maxd-out83/ESP32-S3-Small-Camera-PCB-v2.4/ESP32-S3 Small Camera.kicad_pcb

## KiCad design ESP32-S3 Small Camera.kicad_pcb (2026-07-18)

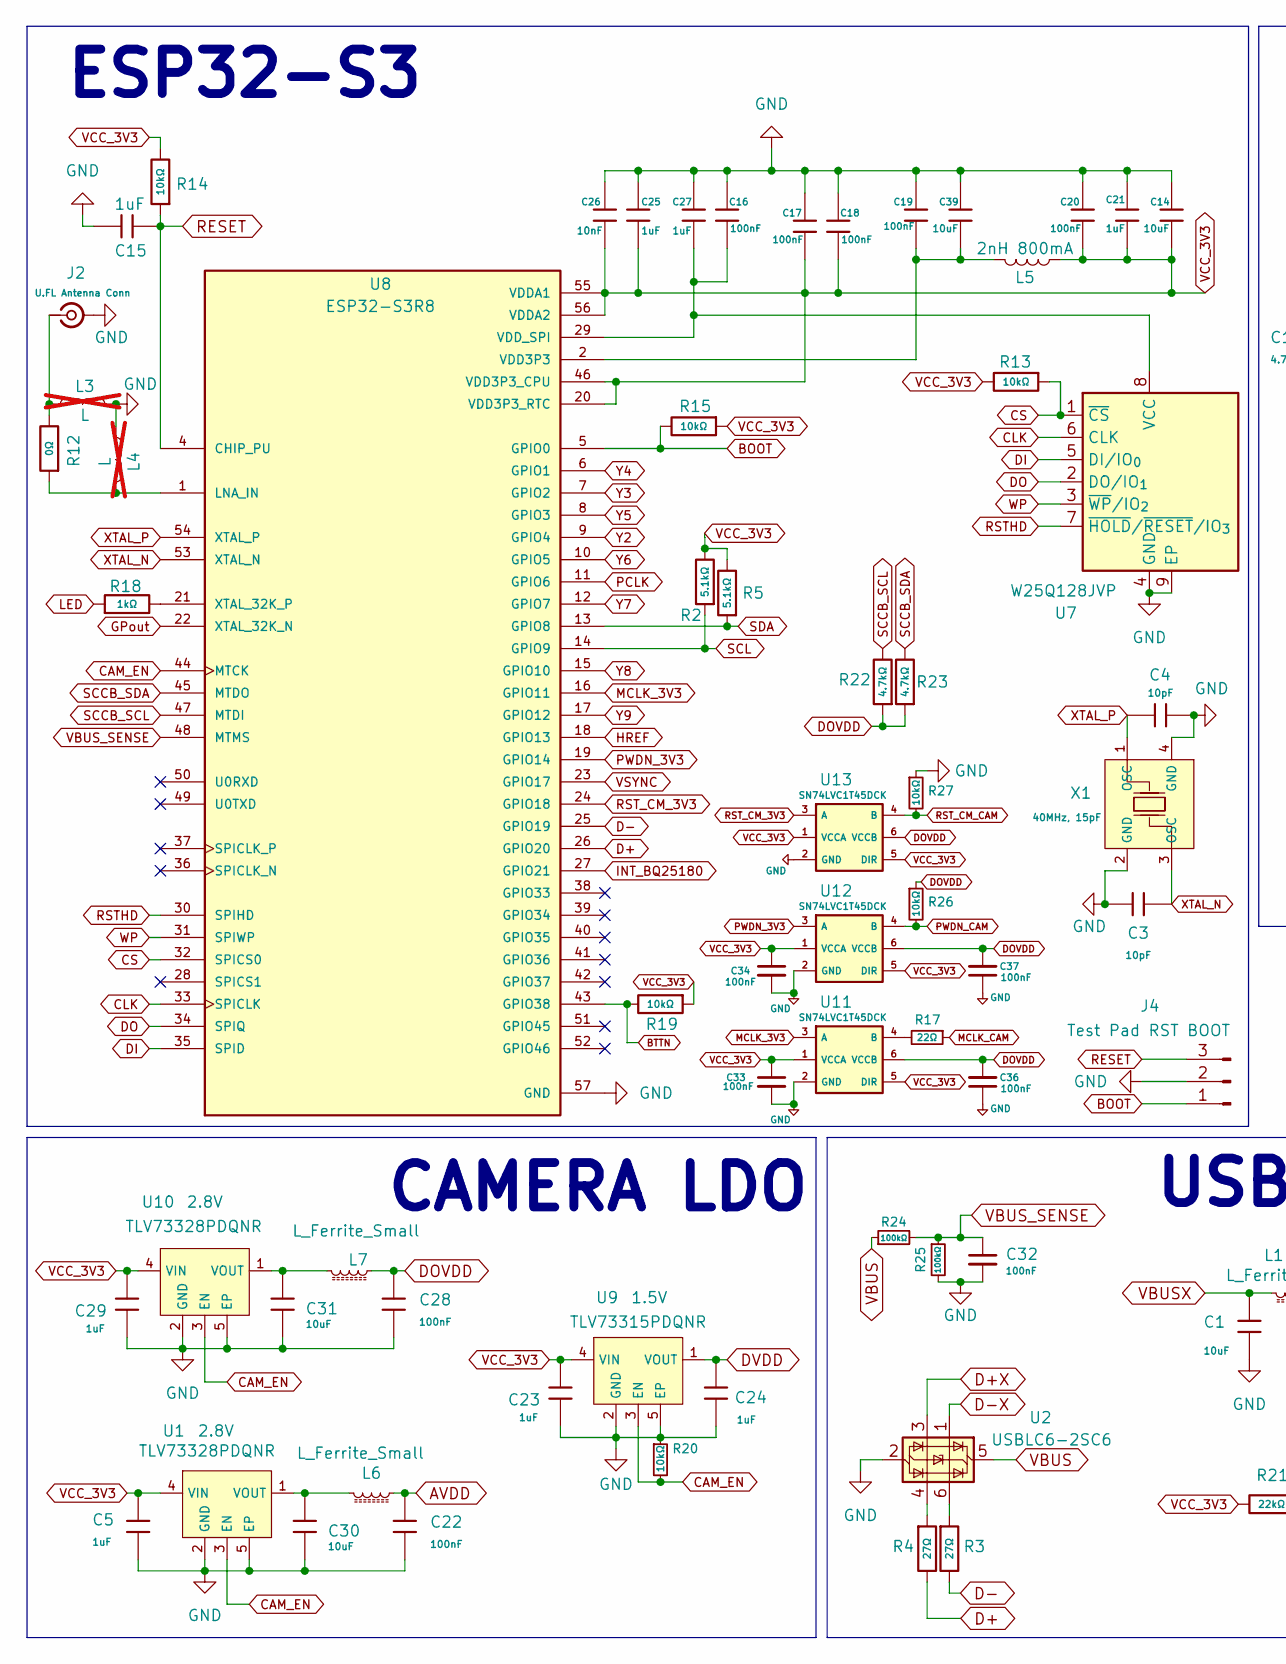
[picture p1: schematic ESP32-S3 Small Camera.kicad_sch, part in row 1, column 1]

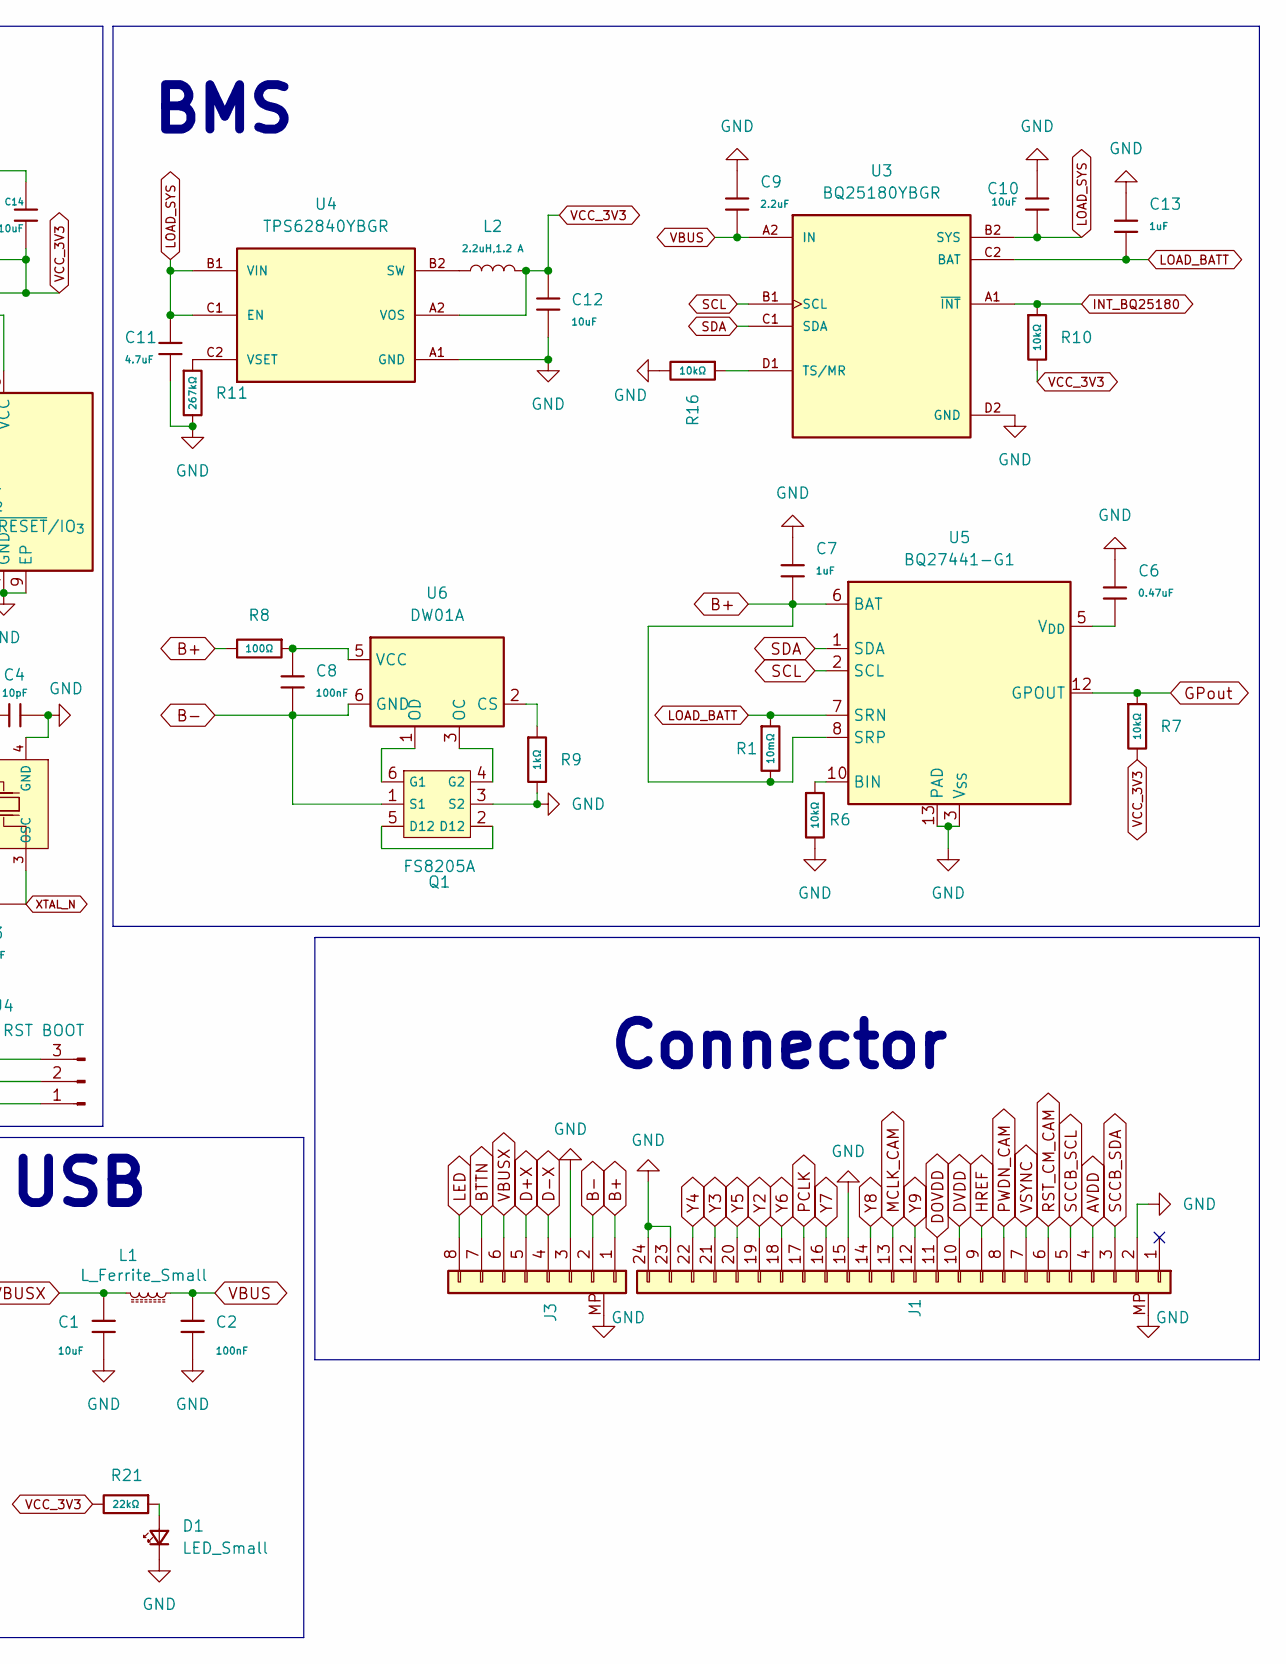
[picture p2: schematic ESP32-S3 Small Camera.kicad_sch, part in row 1, column 2]

Parts:
C1, C10, C12, C14, C30, C31, C39: 10uF; C_0402; LCSC C15525
C2, C8, C16, C17, C18, C19, C20, C22, C28, C32, C33, C34, C36, C37: 100nF; C_0201_0603Metric; LCSC C18164586
C3, C4: 10pF; C_0402_1005Metric; LCSC C32949
C5, C7, C13, C15, C21, C23, C24, C25, C27, C29: 1uF; C_0201_0603Metric; LCSC C53067
C6: 0.47uF; C_0201_0603Metric; LCSC C318543
C9: 2.2uF; C_0201_0603Metric; LCSC C77762
C11: 4.7uF; C_0402; LCSC C23733
C26: 10nF; C_0201_0603Metric; LCSC C526939
D1: LED_Small; LED_0603_1608Metric; LCSC C2286
J1: Conn_01x24; XUNPU_FPC-05F-24PH20_1x24-1MP_P0.5mm_Horizontal; LCSC C2856805
J2: U.FL Antenna Conn; U.FL_Hirose_U.FL-R-SMT-1_Vertical; LCSC C88373
J3: Conn_01x08; JST_SH_SM08B-SRSS-TB_1x08-1MP_P1.00mm_Horizontal; LCSC C160407
J4: Test Pad RST BOOT; TestPoint_Pad_1.0x1.0mm
L1, L6, L7: L_Ferrite_Small; L_0603_1608Metric; LCSC C85833
L2: 2.2uH,1.2 A; L_0805; LCSC C2049745
L3, L4: L; C_0201_0603Metric; not fitted
L5: 2nH 800mA; L_0402_1005Metric; LCSC C3032791
Q1: FS8205A; SOT-23-6; LCSC C908265
R1: 10mΩ; R_0805_2012Metric; LCSC C236283
R2, R5: 5.1kΩ; R_0201_0603Metric; LCSC C270344
R3, R4: 27Ω; R_0201_0603Metric; LCSC C270320
R6, R7, R10, R13, R14, R15, R16, R19, R20, R26, R27: 10kΩ; R_0201_0603Metric; LCSC C473048
R8: 100Ω; R_0402; LCSC C25076
R9, R18: 1kΩ; R_0402; LCSC C11702
R11: 267kΩ; R_0201_0603Metric; LCSC C423627
R12: 0Ω; C_0201_0603Metric; LCSC C270337
R17: 22Ω; R_0201_0603Metric; LCSC C270355
R21: 22kΩ; R_0402_1005Metric; LCSC C25768
R22, R23: 4.7kΩ; R_0201_0603Metric; LCSC C25900
R24, R25: 100kΩ; R_0201_0603Metric; LCSC C25741
U1, U10: TLV73328PDQNR; X2SON-4-EP-1x1; LCSC C2867701
U2: USBLC6-2SC6; SOT-23-6; LCSC C7519
U3: BQ25180YBGR; IC_BQ25180YBGR; LCSC C3682423
U4: TPS62840YBGR; TPS62840; LCSC C2071139
U5: BQ27441-G1; Texas_S-PDSO-N12; LCSC C473397
U6: DW01A; SOT-23-6; LCSC C42380662
U7: W25Q128JVP; WSON-8-1EP_6x5mm_P1.27mm_EP3.4x4.3mm; LCSC C190862
U8: ESP32-S3R8; LCSC C2913194
U9: TLV73315PDQNR; X2SON-4-EP-1x1; LCSC C2867302
U11, U12, U13: SN74LVC1T45DCK; SOT-363_SC-70-6; LCSC C9382
X1: 40MHz, 15pF; Crystal_SMD_2016-4Pin_2.0x1.6mm; LCSC C424432

Connections:
AVDD: C22.1, J1.4, L6.1
B+: C7.2, J3.1, R1.2, R8.2, U5.6 (BAT), U5.8 (SRP)
B-: C8.2, J3.2, Q1.1 (S1), U6.6 (GND)
BOOT: J4.1, R15.2, U8.5 (GPIO0)
BTTN: J3.7, R19.2, U8.43 (GPIO38)
CAM_EN: R20.2, U1.3 (EN), U8.44 (MTCK), U9.3 (EN), U10.3 (EN)
CLK: U7.6 (CLK), U8.33 (SPICLK)
CS: R13.1, U7.1 (~CS), U8.32 (SPICS0)
D+: R4.2, U8.26 (GPIO20)
D+X: J3.5, U2.3 (I/O2)
D-: R3.2, U8.25 (GPIO19)
D-X: J3.4, U2.1 (I/O1)
DI: U7.5 (DI/IO_{0}), U8.35 (SPID)
DO: U7.2 (DO/IO_{1}), U8.34 (SPIQ)
DOVDD: C28.1, C36.2, C37.2, J1.11, L7.1, R22.1, R23.1, R26.1, U11.6 (VCCB), U12.6 (VCCB), U13.6 (VCCB)
DVDD: C24.1, J1.10, U9.1 (VOUT)
GND: C1.2, C2.2, C3.1, C4.1, C5.2, C6.1, C7.1, C9.1, C10.1, C11.2, C12.2, C13.1, C14.1, C15.2, C16.1, C17.1, C18.1, C19.1, C20.1, C21.1, C22.2, C23.2, C24.2, C25.1, C26.1, C27.1, C28.2, C29.2, C30.2, C31.2, C32.2, C33.2, C34.2, C36.1, C37.1, C39.1, D1.1 (K), J1.2, J1.15, J1.23, J1.24, J1.MP, J2.2 (Ext), J3.3, J3.MP, J4.2, L3.2, L4.1, Q1.3 (S2), R6.2, R9.2, R11.2, R16.2, R20.1, R25.2, R27.1, U1.2 (GND), U1.5 (EP), U2.2 (GND), U3.D2 (GND), U4.A1 (GND), U5.3 (V_{SS}), U5.13 (PAD), U7.4 (GND), U7.9 (EP), U8.57 (GND), U9.2 (GND), U9.5 (EP), U10.2 (GND), U10.5 (EP), U11.2 (GND), U12.2 (GND), U13.2 (GND), X1.2 (GND), X1.4 (GND)
GPout: R7.1, U5.12 (GPOUT), U8.22 (XTAL_32K_N)
HREF: J1.9, U8.18 (GPIO13)
INT_BQ25180: R10.1, U3.A1 (~INT), U8.27 (GPIO21)
LED: J3.8, R18.1
LOAD_BATT: C13.2, R1.1, U3.C2 (BAT), U5.7 (SRN)
LOAD_SYS: C10.2, C11.1, U3.B2 (SYS), U4.B1 (VIN), U4.C1 (EN)
MCLK_3V3: U8.16 (GPIO11), U11.3 (A)
MCLK_CAM: J1.13, R17.1
unnamed: D1.2 (A), R21.1
unnamed: J2.1 (In), L3.1, R12.2
unnamed: Q1.2 (D12), Q1.5 (D12)
unnamed: Q1.6 (G1), U6.1 (OD)
unnamed: Q1.4 (G2), U6.3 (OC)
unnamed: R3.1, U2.6 (I/O1)
unnamed: R4.1, U2.4 (I/O2)
unnamed: C30.1, L6.2, U1.1 (VOUT)
unnamed: R16.1, U3.D1 (TS/MR)
unnamed: L2.1, U4.B2 (SW)
unnamed: R11.1, U4.C2 (VSET)
unnamed: R6.1, U5.10 (BIN)
unnamed: C6.2, U5.5 (V_{DD})
unnamed: R9.1, U6.2 (CS)
unnamed: C8.1, R8.1, U6.5 (VCC)
unnamed: C16.2, C27.2, U7.8 (VCC), U8.29 (VDD_SPI)
unnamed: L4.2, R12.1, U8.1 (LNA_IN)
unnamed: R18.2, U8.21 (XTAL_32K_P)
unnamed: C31.1, L7.2, U10.1 (VOUT)
unnamed: R17.2, U11.4 (B)
PCLK: J1.17, U8.11 (GPIO6)
PWDN_3V3: U8.19 (GPIO14), U12.3 (A)
PWDN_CAM: J1.8, R26.2, U12.4 (B)
RESET: C15.1, J4.3, R14.1, U8.4 (CHIP_PU)
RSTHD: U7.7 (~HOLD/~RESET/IO_{3}), U8.30 (SPIHD)
RST_CM_3V3: U8.24 (GPIO18), U13.3 (A)
RST_CM_CAM: J1.6, R27.2, U13.4 (B)
SCCB_SCL: J1.5, R22.2, U8.47 (MTDI)
SCCB_SDA: J1.3, R23.2, U8.45 (MTDO)
SCL: R2.1, U3.B1 (SCL), U5.2 (SCL), U8.14 (GPIO9)
SDA: R5.1, U3.C1 (SDA), U5.1 (SDA), U8.13 (GPIO8)
VBUS: C2.1, C9.2, L1.1, R24.1, U2.5 (VBUS), U3.A2 (IN)
VBUSX: C1.1, J3.6, L1.2
VBUS_SENSE: C32.1, R24.2, R25.1, U8.48 (MTMS)
VCC_3V3: C5.1, C12.1, C14.2, C17.2, C18.2, C20.2, C21.2, C23.1, C25.2, C26.2, C29.1, C33.1, C34.1, L2.2, L5.1, R2.2, R5.2, R7.2, R10.2, R13.2, R14.2, R15.1, R19.1, R21.2, U1.4 (VIN), U4.A2 (VOS), U8.20 (VDD3P3_RTC), U8.46 (VDD3P3_CPU), U8.55 (VDDA1), U8.56 (VDDA2), U9.4 (VIN), U10.4 (VIN), U11.1 (VCCA), U11.5 (DIR), U12.1 (VCCA), U12.5 (DIR), U13.1 (VCCA), U13.5 (DIR)
VDD3P3: C19.2, C39.2, L5.2, U8.2 (VDD3P3), U8.3 (VDD3P3)
VSYNC: J1.7, U8.23 (GPIO17)
WP: U7.3 (~WP/IO_{2}), U8.31 (SPIWP)
XTAL_N: C3.2, U8.53 (XTAL_N), X1.3 (OSC)
XTAL_P: C4.2, U8.54 (XTAL_P), X1.1 (OSC)
Y2: J1.19, U8.9 (GPIO4)
Y3: J1.21, U8.7 (GPIO2)
Y4: J1.22, U8.6 (GPIO1)
Y5: J1.20, U8.8 (GPIO3)
Y6: J1.18, U8.10 (GPIO5)
Y7: J1.16, U8.12 (GPIO7)
Y8: J1.14, U8.15 (GPIO10)
Y9: J1.12, U8.17 (GPIO12)

Notes on the sheet:
BMS
ESP32-S3
USB
Connector
CAMERA LDO

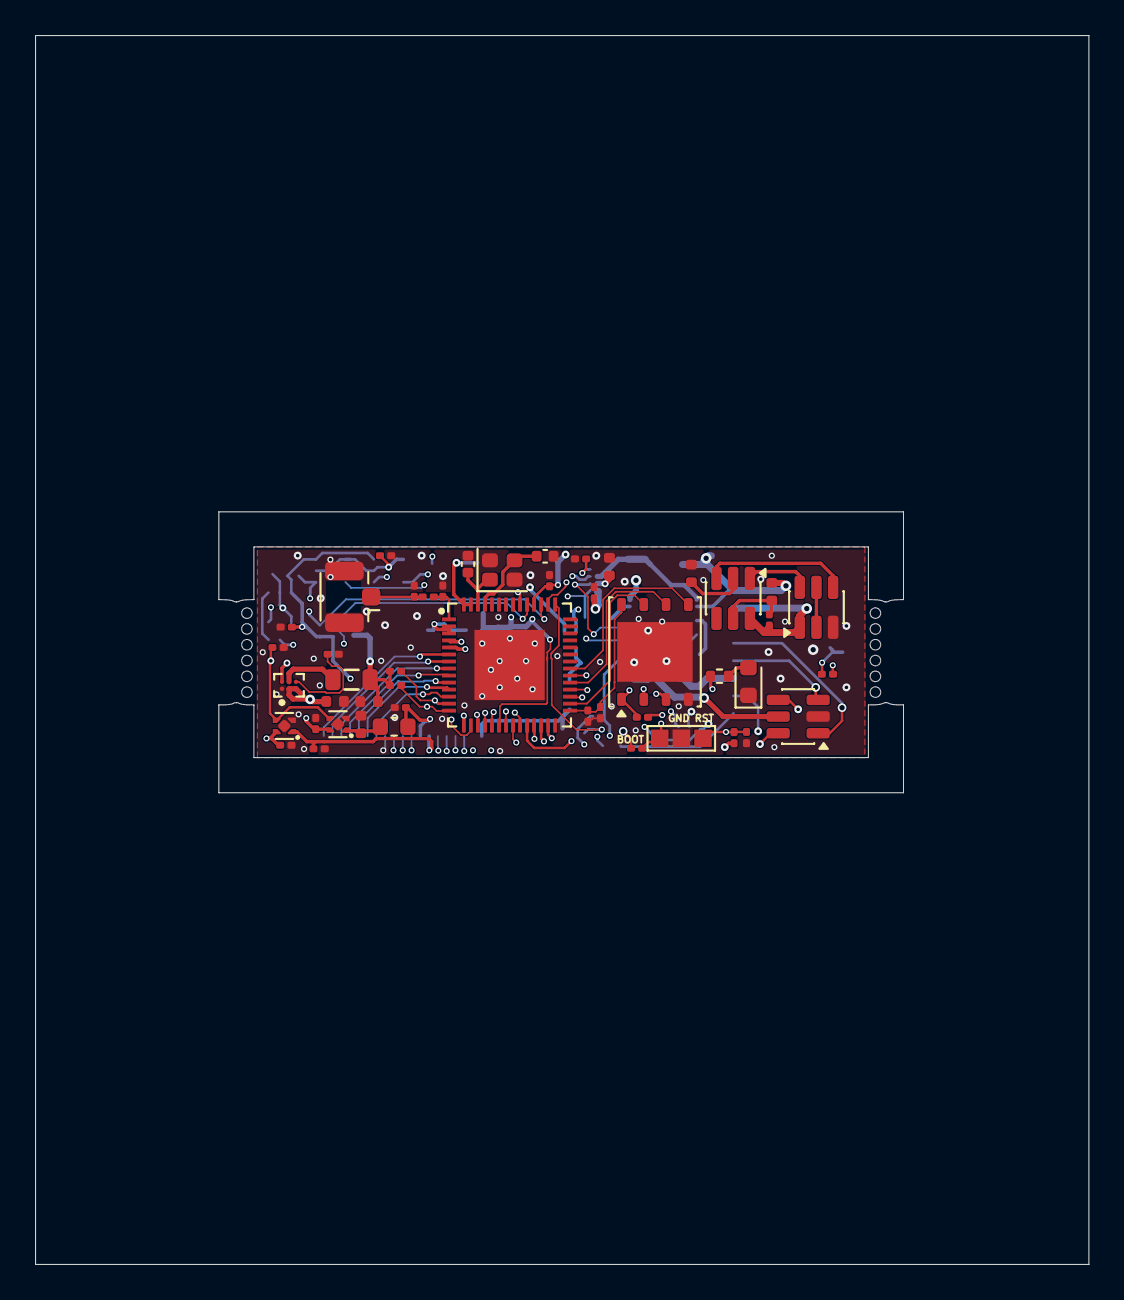
[picture p3: board ESP32-S3 Small Camera.kicad_pcb from above]

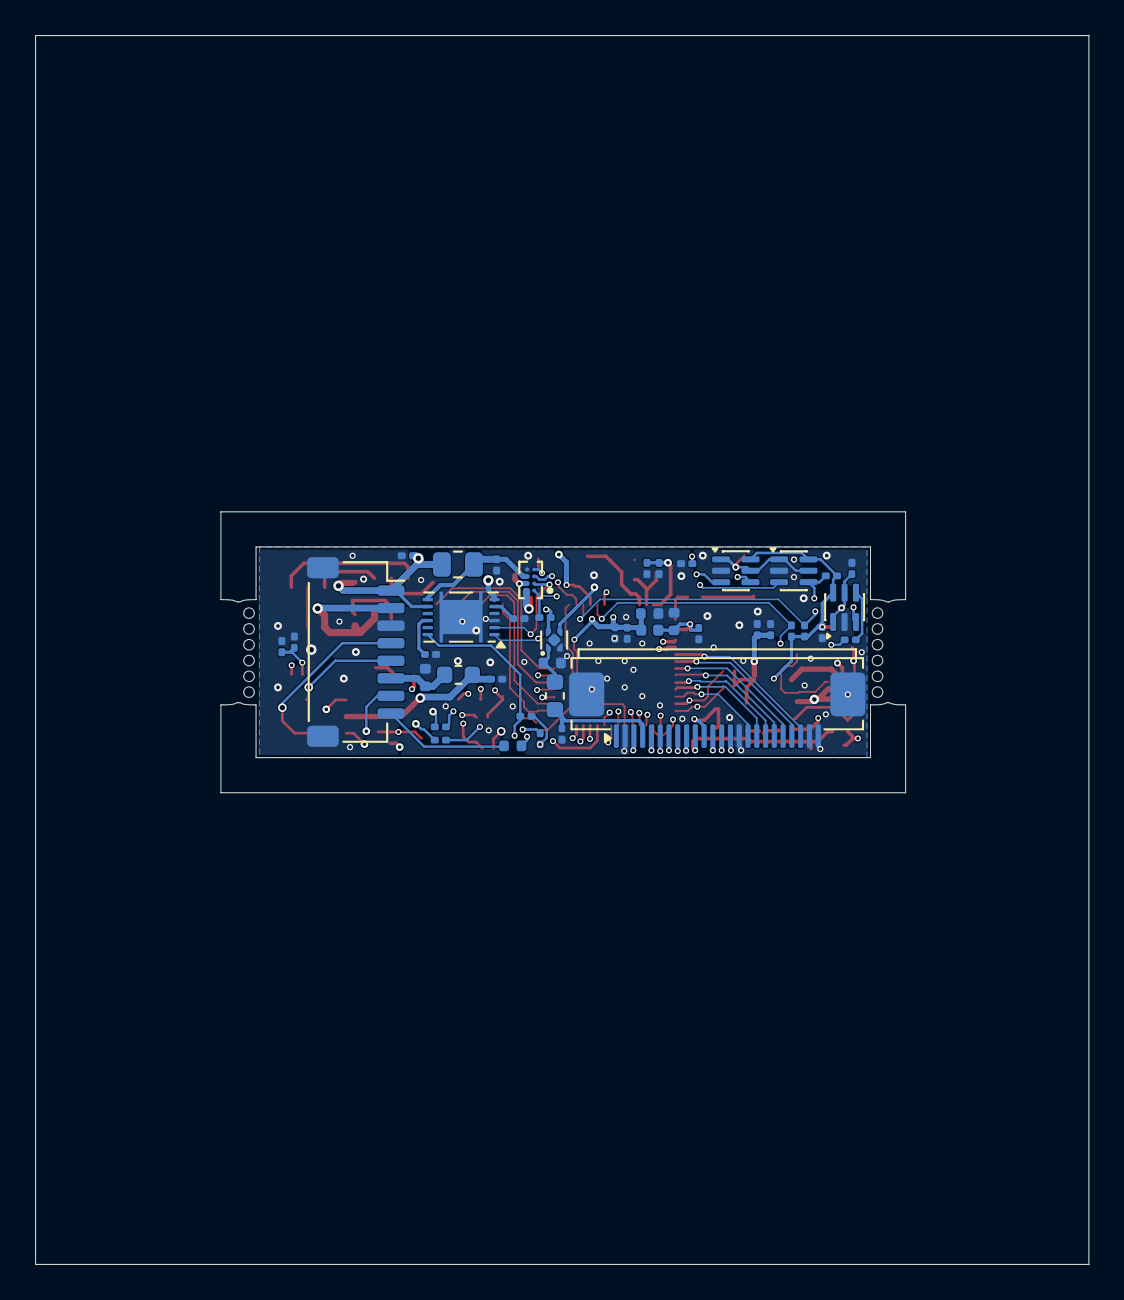
[picture p4: board ESP32-S3 Small Camera.kicad_pcb from below]

Board: 8 copper layers, 60.0 x 70.0 mm, 91 parts (44 on the bottom side), 73 nets.
