maxd-out83/ESP32-S3-Small-Camera-PCB-v2.4/(commit log)

2026-07-12 Added Existing PCB
    Moving Project to GitHub.
    Current change over "v2.3 U.FL" is a conversion to 6 layers for better zone connectivity and reliability. Made changes to schematic to fix bugs. PCB itself is in an uncompleted state thus far.
    [ESP32-S3 Small Camera.kicad_pcb, ESP32-S3 Small Camera.kicad_sch]
2026-07-14 PCB Layout
    Switched from 6 -> 8 layers
    Routed and placed all components
    [ESP32-S3 Small Camera.kicad_pcb]
2026-07-14 Fixed bugs, rerouted ln.5 track
    [ESP32-S3 Small Camera.kicad_pcb]
2026-07-14 Rerouted, cleaned up
    [ESP32-S3 Small Camera.kicad_pcb, ESP32-S3 Small Camera.kicad_sch]
2026-07-14 Finalize PCB
    [ESP32-S3 Small Camera.kicad_pcb]
2026-07-18 Manufacturing Files Updated
    [ESP32-S3 Small Camera-B_Cu.gbr, ESP32-S3 Small Camera-B_Mask.gbr, ESP32-S3 Small Camera-B_Paste.gbr, ESP32-S3 Small Camera-B_Silkscreen.gbr, ESP32-S3 Small Camera-Edge_Cuts.gbr, ESP32-S3 Small Camera-F_Cu.gbr, ESP32-S3 Small Camera-F_Mask.gbr, ESP32-S3 Small Camera-F_Paste.gbr]
